nexform-tech/litearm-docs/LITEARM-SE DH参数.pdf

# DH 参数

NEXFORM ROBOTICS

版本：V1.0 日期：2026 年 11 月 2 日

## 修订记录

版本 | 修订时间 | 修订记录
V1.0 | 2026‐11‐02 | 客户使用版本首发
NEXFORM ROBOTICS | I

目录

NEXFORM ROBOTICS | II

LITEARM SE DH 参数

## 1 坐标系与符号约定

采用改进 DH（Craig/MDH）约定，相邻连杆坐标系之间的齐次变换为：

Ti−1→i = Rx(αi) · Tx(ai) · Rz(θi) · Tz(di)

θi = offseti + si
- qi

其中：i 为关节编号（1–7）；αi 为绕 x 轴的扭角；ai 为沿 x 轴的长度；di 为沿 z 轴的偏置；offseti 为零位偏 置；si 为关节方向系数；qi 为关节角。角度单位为 °，长度单位为 m，q 单位为 rad。
注意：改进 DH 的变换顺序为 Rx → Tx → Rz → Tz，与标准 DH（Rz → Tz → Tx → Rx）不同，请勿混用。

## 2 改进 DH 参数表

表 1 | LiteArm 改进 DH 参数
关节 i | αi
(°) ai
(m) di
(m) θ 偏置 (°) si
1 | 0 | 0 | 0.13325 | 0 | +1
2 | −90 | 0 | 0 | 0 | +1
3 | 90 | 0 | 0.2995 | 0 | +1
4 | −90 | 0.038 | 0 | 0 | −1
5 | 90 | −0.038 | 0.2225 | 0 | +1
6 | −90 | 0 | 0 | 90 | −1
7 | 90 | −0.074 | 0 | 0 | −1

7 个关节均为旋转关节；si 为 +1 表示关节正方向与 DH 的 z 轴同向，−1 表示反向。表中 α 与 offset 为精确的 ±90° 整数倍，a、d 为设计值。
运动学计算时，将参数按关节序号代入上式即可；各连杆动力学参数另行提供。
NEXFORM ROBOTICS | 1
