nexform-tech/litearm-docs/LITEARM_SE_images/fig_arm_demo_iso.png

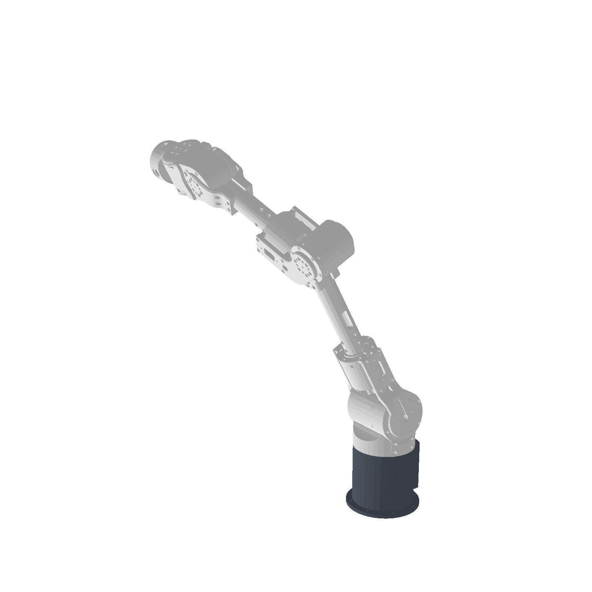
LITEARM_SE_images/fig_arm_demo_iso.png
