nexform-tech/litearm-docs/LITEARM_SE_images/fig_arm_zero_iso.png

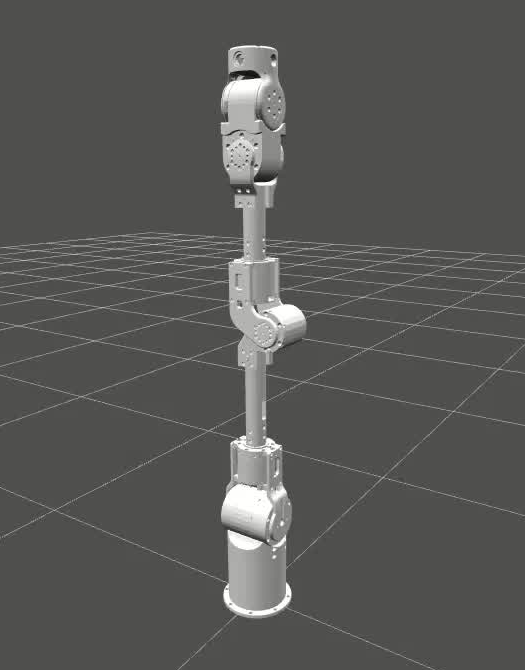
LITEARM_SE_images/fig_arm_zero_iso.png
