nexform-tech/litearm-docs/LITEARM_SE_images/litearm_studio/12_teleop_console.png

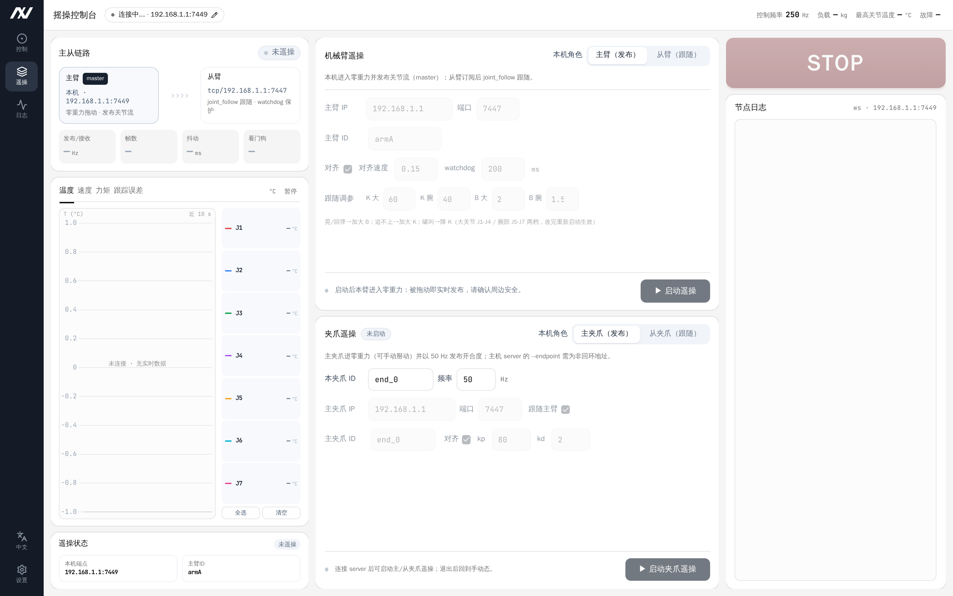
LITEARM_SE_images/litearm_studio/12_teleop_console.png
