nexform-tech/litearm-docs/LITEARM_SE_images/litearm_studio/13_telemetry_samples.png

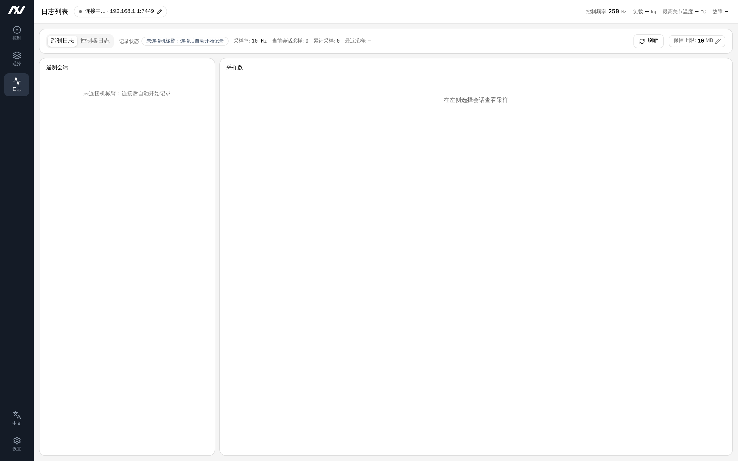
LITEARM_SE_images/litearm_studio/13_telemetry_samples.png
