nexform-tech/litearm-docs/LITEARM_SE_images/litearm_studio/15_controller_logs.png

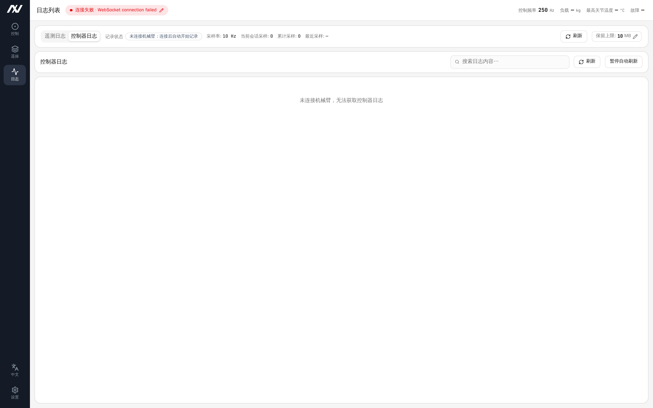
LITEARM_SE_images/litearm_studio/15_controller_logs.png
