nexform-tech/litearm-docs/LITEARM_SE_images/litearm_studio/16_settings_payload.png

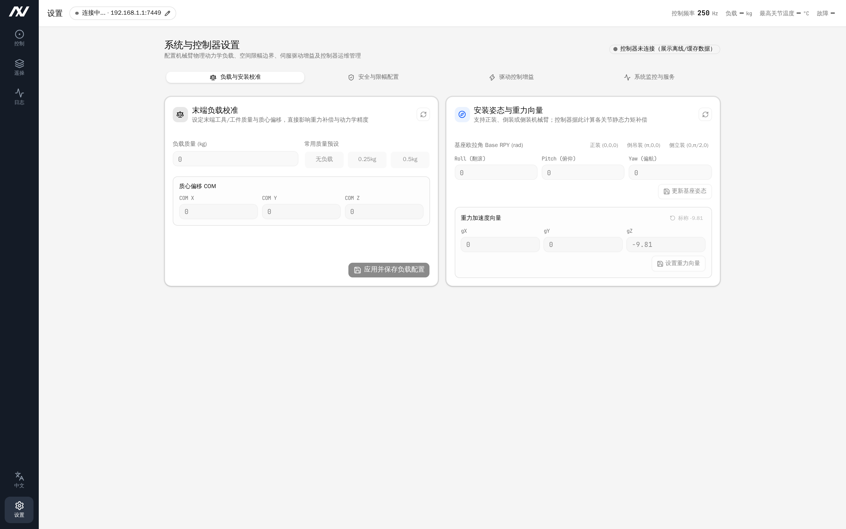
LITEARM_SE_images/litearm_studio/16_settings_payload.png
