nexform-tech/litearm-docs/LITEARM_SE_images/litearm_studio/17_settings_safety.png

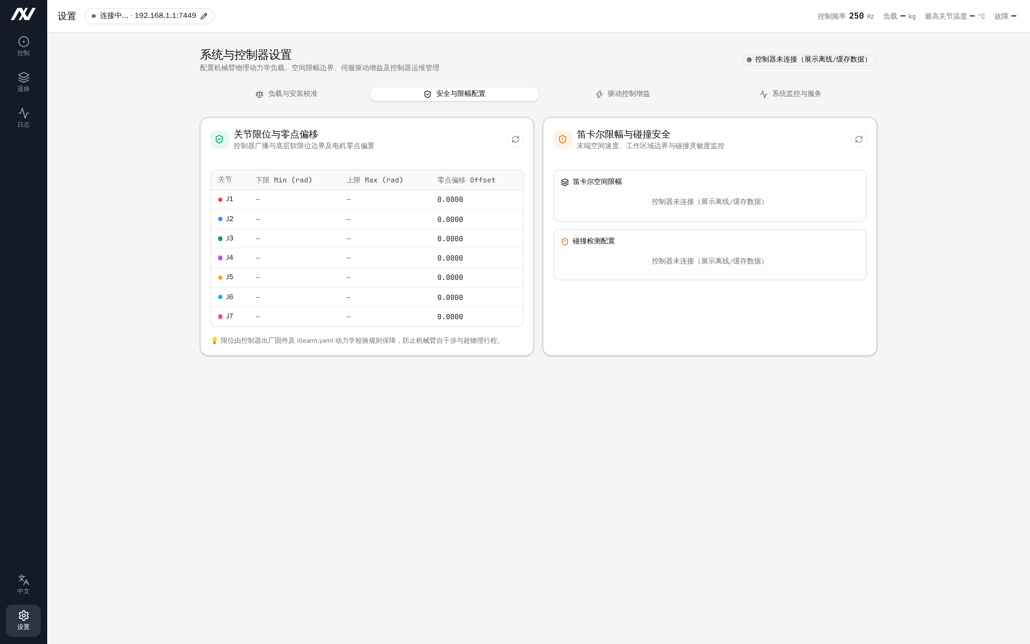
LITEARM_SE_images/litearm_studio/17_settings_safety.png
