nexform-tech/litearm-docs/LITEARM_SE_images/litearm_studio/19_settings_system.png

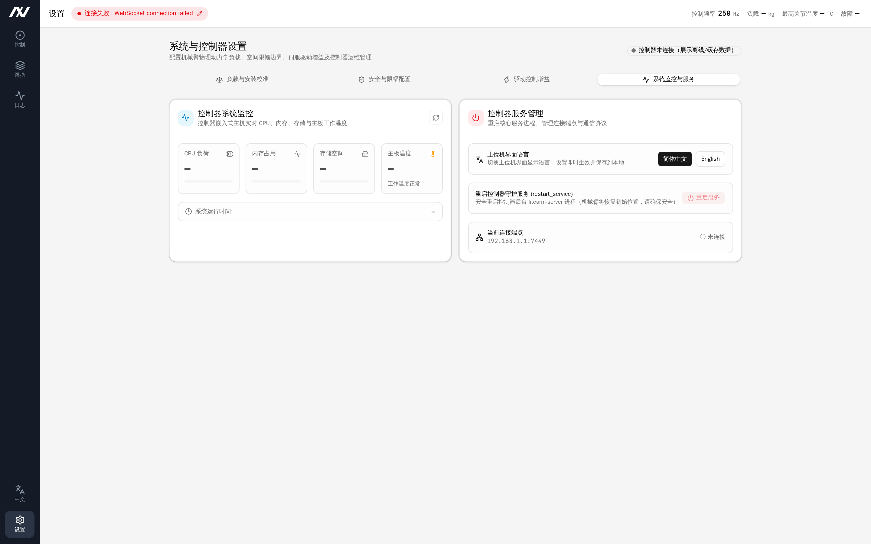
LITEARM_SE_images/litearm_studio/19_settings_system.png
