nexform-tech/litearm-docs/LITEARM_SE_images/placeholders/ph_pm_gripper_dir.png

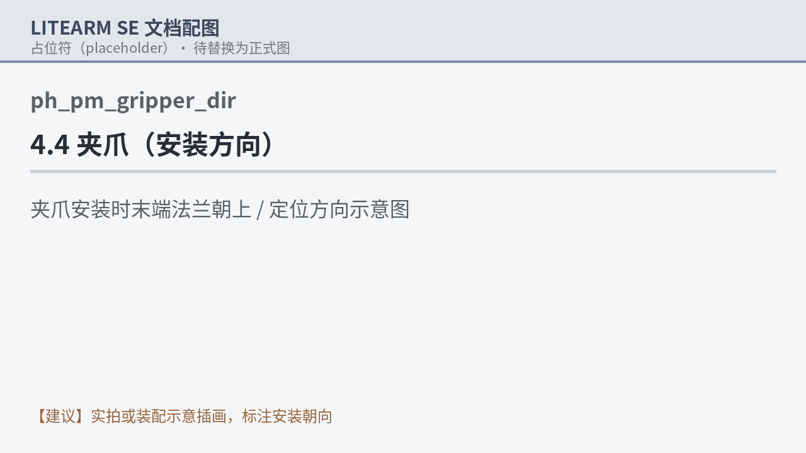
LITEARM_SE_images/placeholders/ph_pm_gripper_dir.png
