nexform-tech/litearm-docs/LITEARM_SE_images/placeholders/ph_pm_gripper_top.png

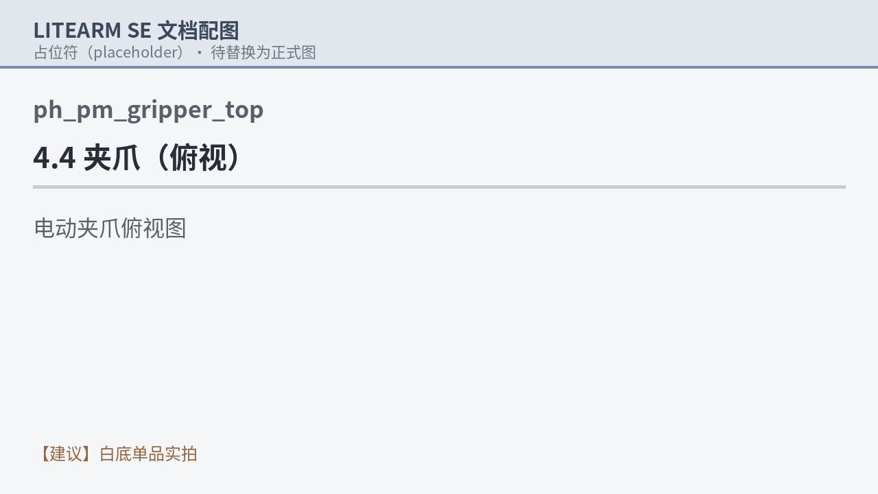
LITEARM_SE_images/placeholders/ph_pm_gripper_top.png
