nexform-tech/litearm-docs/LITEARM_SE_images/placeholders/ph_pm_openbox.png

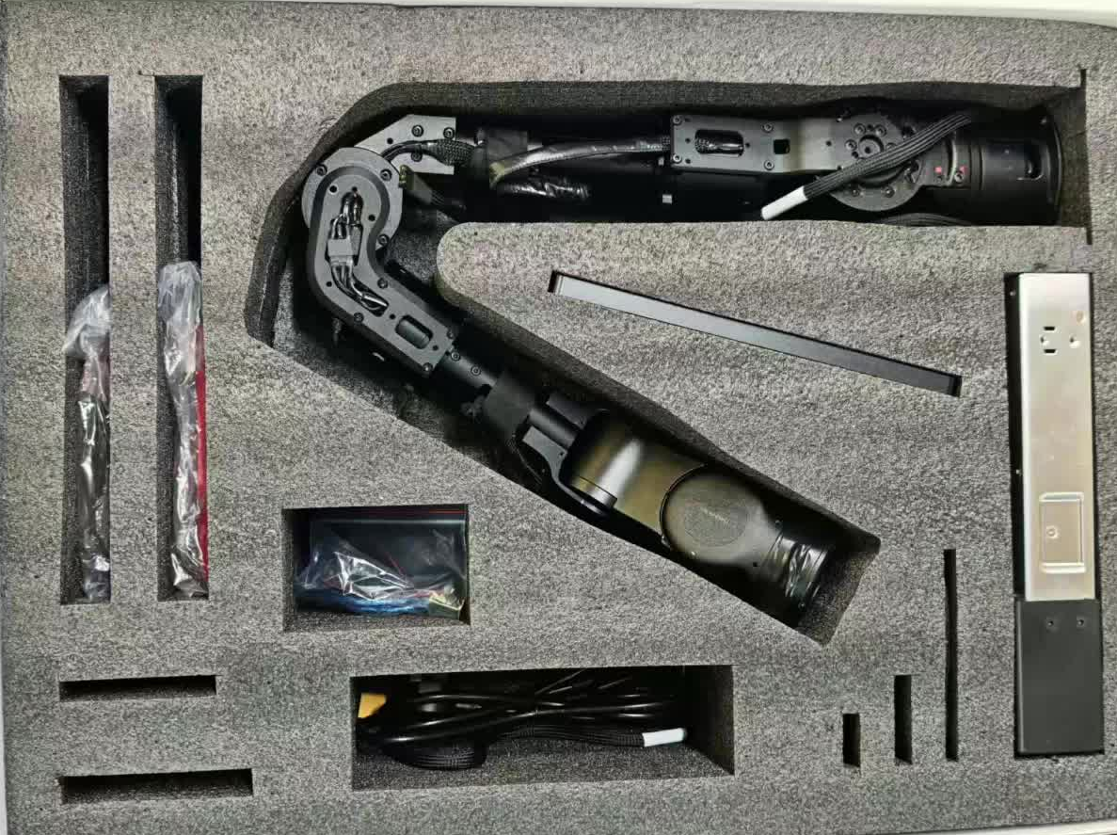
LITEARM_SE_images/placeholders/ph_pm_openbox.png
