nexform-tech/litearm-docs/LITEARM_SE_images/placeholders/ph_pm_teach.png

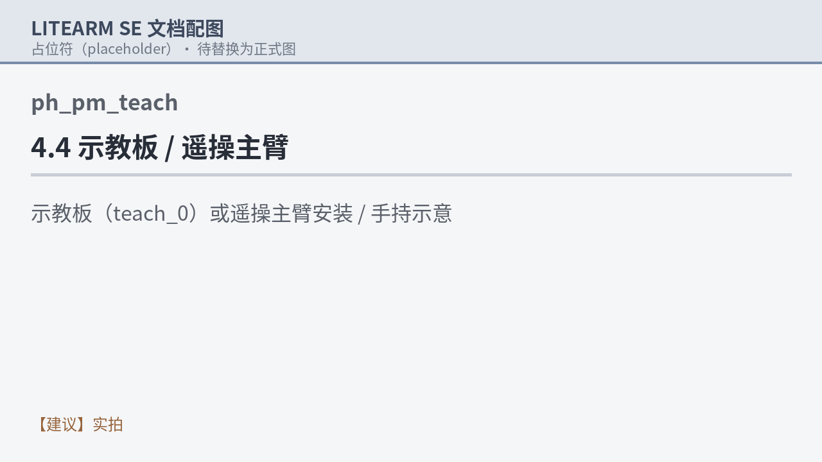
LITEARM_SE_images/placeholders/ph_pm_teach.png
