nexform-tech/litearm-docs/LITEARM_SE_images/placeholders/ph_sd_arch.png

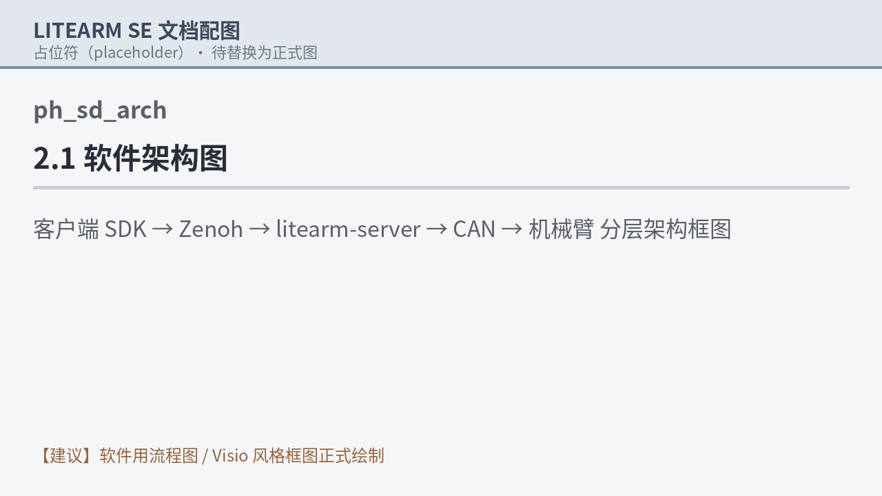
LITEARM_SE_images/placeholders/ph_sd_arch.png
