nexform-tech/litearm-docs/LITEARM_SE_images/placeholders/ph_sd_ui_dragprog.png

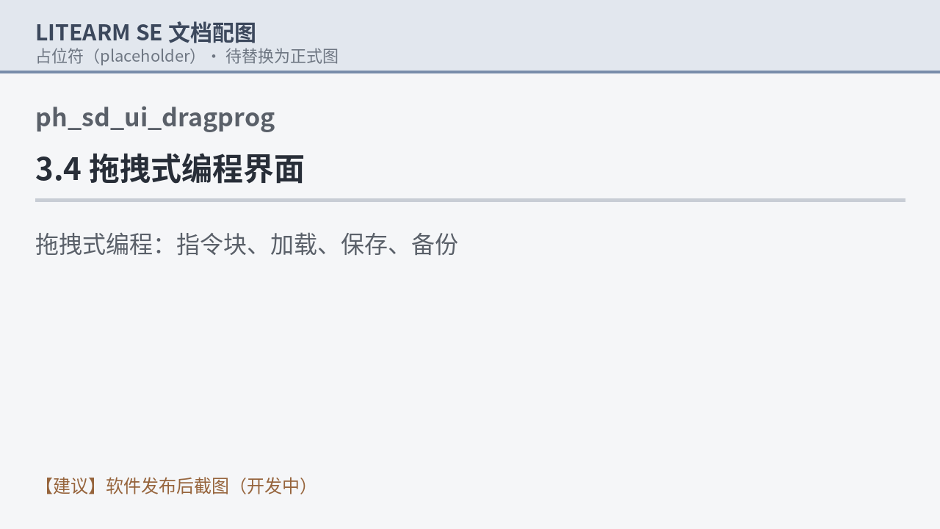
LITEARM_SE_images/placeholders/ph_sd_ui_dragprog.png
