nexform-tech/litearm-docs/LITEARM_SE_images/placeholders/ph_sd_ui_realtime.png

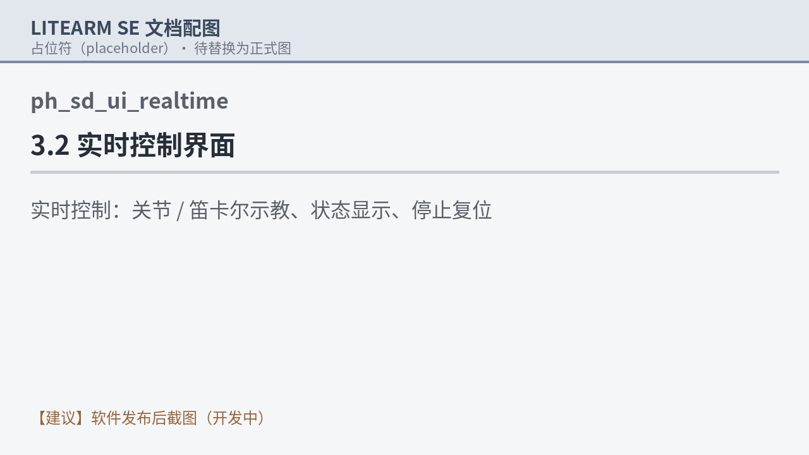
LITEARM_SE_images/placeholders/ph_sd_ui_realtime.png
