nexform-tech/litearm-docs/LITEARM_SE_images/safety/en/danger.png

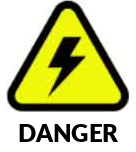
LITEARM_SE_images/safety/en/danger.png
