nexform-tech/litearm-docs/LITEARM_SE_images/safety/en/high_temp.png

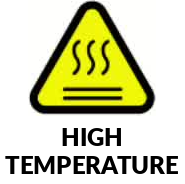
LITEARM_SE_images/safety/en/high_temp.png
