nexform-tech/litearm-docs/LITEARM-SE-step-model.STEP

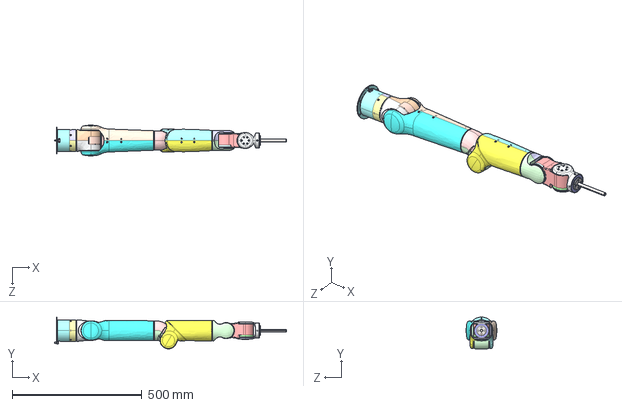
[picture p27: CAD file, 2026-11-06]
LITEARM-SE-step-model.STEP
895.0 x 122.5 x 118.2 mm
