nexform-tech/litearm-docs/LITEARM-SE末端连接件.STEP

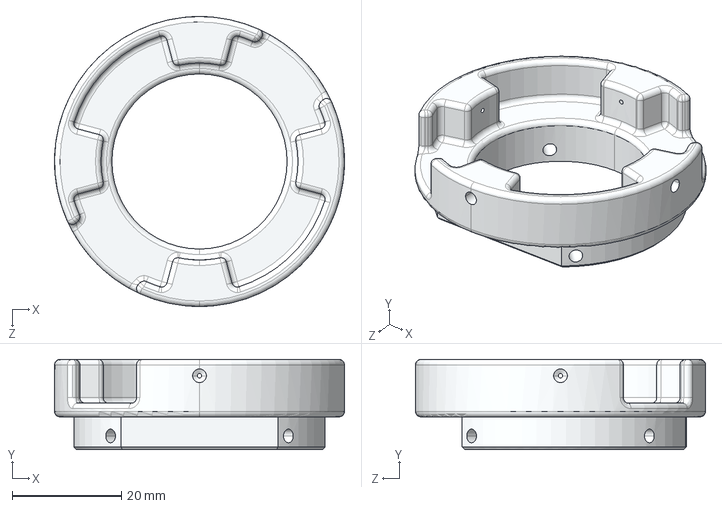
[picture p28: CAD file, 2026-11-03]
LITEARM-SE末端连接件.STEP
53.0 x 16.5 x 53.0 mm
