nexform-tech/litearm-docs/drawings/column-assembly-dimensions.pdf

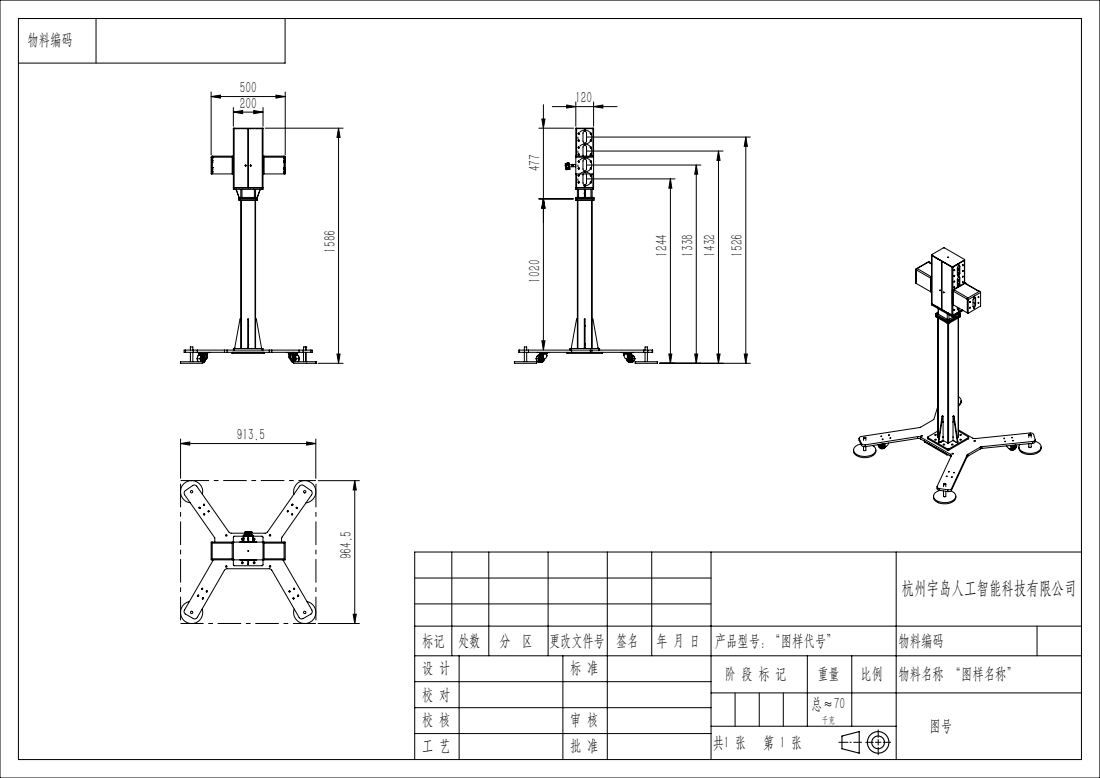
[picture p29: page 1]

杭州宇岛人工智能科技有限公司

标记 | 处数 | 分 区 | 更改文件号 | 签名 | 年 月 日 | 产品型号： “图样代号” | 物料编码
设 计 | | 标 准 | | 阶 段 标 记 | 重量 | 比例 | 物料名称 “图样名称”
校 对
校 核 | | 审 核
工 艺 | | 批 准
