nexform-tech/litearm-docs/(commit log)

2026-10-16 docs: add English editions of the LITEARM SE manuals (#7)
    * build: make the PDF pipeline language-aware
    a3_layout.tex carried the CJK line-breaking settings, the simplified
    Chinese body font and the Chinese 目录 / 图 strings, so it could only
    typeset a Chinese manual. Turn each of those into a placeholder that
    build_a3.sh fills from the language each manual is built in.
    The English build loads no CJK package at all and only swaps the
    monospace font, because the directory-tree and link diagrams use U+2500
    box drawing that Latin Modern Mono does not have.
    Also fail on a placeholder written inside a TeX comment. The
    substituted blocks are multi-line, so one landing after a % ends the
    comm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
2026-10-16 fix: draw each hazard sign label once (#9)
    The four hazard icons in LITEARM_SE_images/safety/ are bitmaps with the
    Chinese word baked into the lower third. The Chinese product manual sets that
    same word again in LaTeX under the picture, so every one of its four signs
    printed the word twice: once rasterised, once in type. The offline site did
    the same, because build/make_wiki.py draws the label as HTML text below the
    same PNGs. The English manuals did not, which is why they kept a second,
    relabelled copy of the icons in safety/en/, written by
    build/make_safety_icons.py.
    Crop the word off the four PNGs. The triangles that remain carry no
    language, so one set now serves all four manuals and ea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
2026-11-03 feat: sync PDFs to the Feishu doc center (#11)
    * feat: sync PDFs to the Feishu doc center
    更新仓库里的 PDF 后，把飞书文档里的同名文件块换成新版本。块不重建，位置与分享权限保持不变。
    * fix: skip the authorization header on the token request
2026-11-03 feat: add the SE end connector drawing, DH parameters and STEP (#12)
    Publish the two customer documents in the manual template (NEXFORM cover,
    revision record and typography) and commit the end connector's STEP model
    next to them.
    The Feishu sync now also covers the drawing, the DH sheet and the STEP file,
    so all three file blocks in the document center follow the repository.
2026-11-03 fix: verify each Feishu file block after replacing it (#13)
    * fix: verify each Feishu file block after replacing it
    replace_file can answer code 0 while the block still points at the old
    file, and a run that silently does nothing still reports success. Read
    the block back, compare its token with the one just uploaded, and
    download the media to compare it with the repository file, so a no-op
    fails the workflow instead of passing as green.
    * fix: drop the STEP file from the Feishu sync config
    The page no longer carries a file block named LITEARM-SE末端连接件.STEP:
    it was synced at 06:19 but the model-file table was removed afterwards.
    With the entry still listed, the next sync run stop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
2026-11-06 docs: add the camera bracket mounting guide (#22)
2026-11-06 docs: add the English edition of the camera bracket guide (#23)
2026-11-09 docs: build the camera bracket guide from markdown (#24)
    The camera bracket guide shipped as a PDF whose words were drawn into the
    figures, which made it the one document here with no source and no build
    step. It now builds like the manuals.
    The callout text is blanked out of the three CAD plates and replaced by the
    red circled numeral that used to sit at the end of each leader line; the
    words live in the table under each figure, numbered to match. One set of
    figures therefore serves both editions, in the same way the manuals share
    every figure that is not a screenshot of the user interface.
    - 相机支架安装使用方式.md and camera-bracket-guide.md: the two sources
    - LITEARM_SE_image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
2026-11-10 docs: add the column model and its outline drawing (#25)
    The vertical column the arm mounts on had no model or drawing in the
    repository, so neither could be published to the documentation centre or
    handed to anyone without a copy of the CAD file.
    - LITEARM-SE-column-model.STEP: the column assembly, from 立式立柱模型文件.STEP
    - drawings/column-assembly-dimensions.pdf: the overall outline dimensions and
    hole positions, from 立式立柱总装配体外轮廓尺寸图.pdf
    The names follow the existing ones (`LITEARM-SE-step-model.STEP` and the
    `*-dimensions.pdf` set under `drawings/`); the drawings are all named in ASCII
    so a tool that mangles an encoding cannot lose them.
2026-11-10 fix: re-encode the column model as UTF-8 (#26)
    SolidWorks wrote the part name into the STEP header in the system code page, so
    `FILE_NAME` held GBK and the file as a whole was not valid UTF-8. Anything that
    treats it as text and re-encodes it changes it — the contents API returns such a
    blob as UTF-8 of its Latin-1 reading, 228 bytes longer, without an error.
    The text is decoded as GBK and written back as UTF-8: the same 370,125 lines and
    282,893 entities, the same character in every name, 64 bytes longer because each
    character now takes three bytes instead of two. The arm model has always been
    UTF-8; this one now matches.
    CONTRIBUTING says how to check a new export, since the next one w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
